nandoo10/PECI-g7-Mobile-Heart-Box/codigos_finais/thermal_app/assets/images/fundo.jpg

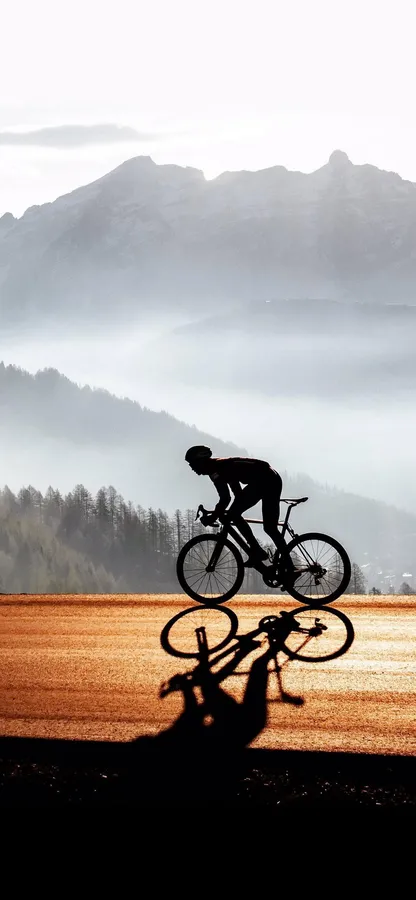
codigos_finais/thermal_app/assets/images/fundo.jpg
