nandoo10/PECI-g7-Mobile-Heart-Box/(commit log)

2026-04-20 codigo dos sensores independente
2026-05-03 Material PC Tiago
2026-05-04 Adiciona pasta de material
2026-05-07 Enhance thermal sensor handling and UI
    Added new functionalities for thermal sensor processing and visualization.
2026-05-11 Implement ON/OFF control command functionality
    Added a function to send control commands for ON/OFF functionality, including error handling for MQTT connection. Updated UI to include manual control buttons for the devices.
2026-05-11 Remove manual control function and UI elements
    Removed the _sendControlCommand function and related UI elements for manual control of devices. Updated comments and cleaned up code structure.
2026-05-12 Enhance Bluetooth device name handling and checks
    Refactor device name retrieval and improve board identification logic.
2026-05-19 Update print statement from 'Hello' to 'Goodbye'
2026-05-20 Replace ECG with real-time BPM tracking
    Replaced ECG functionality with real-time BPM tracking and updated chart display. Adjusted logic for BPM calibration and added dynamic graphing for live BPM data.
2026-06-09 Limpeza total do repositório para nova estrutura
2026-06-09 Adiciona nova estrutura de pastas e ficheiros do projeto
